ZMinghuiZ/Alex-to-the-Rescue/README.md

# Alex-to-the-Rescue
A tele-operated search and rescue robot using Raspberry Pi, Arduino UNO, Robot Operating System (ROS), color detector and LiDAR. Able to identify obstacles and navigate in unknown environment and generate 2D layout with LiDAR.
