ZMinghuiZ/Alex-to-the-Rescue/tls-alex-client.cpp

// Routines to create a TLS client
#include "make_tls_client.h"

// Network packet types
#include "netconstants.h"

// Packet types, error codes, etc.
#include "constants.h"

#include <conio.h>

// Tells us that the network is running.
static volatile int networkActive=0;

void handleError(const char *buffer)
{
	switch(buffer[1])
	{
		case RESP_OK:
			printf("Command / Status OK\n");
			break;

		case RESP_BAD_PACKET:
			printf("BAD MAGIC NUMBER FROM ARDUINO\n");
			break;

		case RESP_BAD_CHECKSUM:
			printf("BAD CHECKSUM FROM ARDUINO\n");
			break;

		case RESP_BAD_COMMAND:
			printf("PI SENT BAD COMMAND TO ARDUINO\n");
			break;

		case RESP_BAD_RESPONSE:
			printf("PI GOT BAD RESPONSE FROM ARDUINO\n");
			break;

		default:
			printf("PI IS CONFUSED!\n");
	}
}

void handleStatus(const char *buffer)
{
	int32_t data[16];
	memcpy(data, &buffer[1], sizeof(data));

	printf("\n ------- ALEX STATUS REPORT ------- \n\n");
//	printf("Left Forward Ticks:\t\t%d\n", data[0]);
//	printf("Right Forward Ticks:\t\t%d\n", data[1]);
//	printf("Left Reverse Ticks:\t\t%d\n", data[2]);
//	printf("Right Reverse Ticks:\t\t%d\n", data[3]);
//	printf("Left Forward Ticks Turns:\t%d\n", data[4]);
//	printf("Right Forward Ticks Turns:\t%d\n", data[5]);
//	printf("Left Reverse Ticks Turns:\t%d\n", data[6]);
//	printf("Right Reverse Ticks Turns:\t%d\n", data[7]);
//	printf("Forward Distance:\t\t%d\n", data[8]);
//	printf("Reverse Distance:\t\t%d\n", data[9]);

    // display colour according to threshold set in Arduino's code
	if (data[10] == 0)
    {
        printf("Colour: RED\n");
    }
    else if (data[10] == 1)
    {
        printf("Colour: GREEN\n");
    }
    else
    {
        printf("NOT VICTIM\n");
    }

    // display RGB values, in case colour scanning is not accurate so we can determine manually
    printf("RGB: %d - %d - %d\n", data[12], data[14], data[13]);

    printf("gap:\t\t%d\n", data[11]);
	printf("\n---------------------------------------\n\n");
}

void handleMessage(const char *buffer)
{
	printf("MESSAGE FROM ALEX: %s\n", &buffer[1]);
}

void handleCommand(const char *buffer)
{
	// We don't do anything because we issue commands
	// but we don't get them. Put this here
	// for future expansion
}

void handleNetwork(const char *buffer, int len)
{
	// The first byte is the packet type
	int type = buffer[0];

	switch(type)
	{
		case NET_ERROR_PACKET:
		handleError(buffer);
		break;

		case NET_STATUS_PACKET:
		handleStatus(buffer);
		break;

		case NET_MESSAGE_PACKET:
		handleMessage(buffer);
		break;

		case NET_COMMAND_PACKET:
		handleCommand(buffer);
		break;
	}
}

void sendData(void *conn, const char *buffer, int len)
{
	int c;
	printf("\nSENDING %d BYTES DATA\n\n", len);
	if(networkActive)
	{
		/* TODO: Insert SSL write here to write buffer to network */
        c = sslWrite(conn, buffer, len);
		/* END TODO */

		networkActive = (c > 0);
	}
}

void *readerThread(void *conn)
{
	char buffer[128];
	int len;

	while(networkActive)
	{
		/* TODO: Insert SSL read here into buffer */
        len = sslRead(conn, buffer, sizeof(buffer));

        printf("Read %d bytes from server.\n", len);
		/* END TODO */

		networkActive = (len > 0);

		if(networkActive)
			handleNetwork(buffer, len);
	}

	printf("Exiting network listener thread\n");

    /* TODO: Stop the client loop and call EXIT_THREAD */
    stopClient();
    EXIT_THREAD(conn);
    /* END TODO */
}

void flushInput()
{
	char c;

	while((c = getchar()) != '\n' && c != EOF);
}

void getParams(int32_t *params)
{
	printf("Enter distance/angle in cm/degrees (e.g. 50) and power in %% (e.g. 75) separated by space.\n");
	printf("E.g. 50 75 means go at 50 cm at 75%% power for forward/backward, or 50 degrees left or right turn at 75%%  power\n");
	scanf("%d %d", &params[0], &params[1]);
	flushInput();
}

void *writerThread(void *conn)
{
	int quit=0;

	while(!quit)
	{
		char ch;
		printf("Command (p=arrow key control)\n");
		printf("Command (f=forward, b=reverse, l=turn left, r=turn right, s=stop, c=clear stats, g=get stats q=exit)\n");
		scanf("%c", &ch);

		// Purge extraneous characters from input stream
		flushInput();

		char buffer[10];
		int32_t params[2];
		int keypress;

		buffer[0] = NET_COMMAND_PACKET;
		switch(ch)
		{
			case 'f':
			case 'F':
			case 'b':
			case 'B':
			case 'l':
			case 'L':
			case 'r':
			case 'R':
						getParams(params);
						buffer[1] = ch;
						memcpy(&buffer[2], params, sizeof(params));
						sendData(conn, buffer, sizeof(buffer));
						break;
			case 's':
			case 'S':
			case 'c':
			case 'C':
			case 'g':
			case 'G':
					params[0]=0;
					params[1]=0;
					memcpy(&buffer[2], params, sizeof(params));
					buffer[1] = ch;
					sendData(conn, buffer, sizeof(buffer));
					break;
			case 'q':
			case 'Q':
				quit=1;
				break;

            // UI for keyboard controls
            // continuously reads for keypress, then sends pre-determined params
            case 'p':
                printf("WASDzx movement, r/u=f/b hump, t/y=big L/R, g=status, h=stop, q=quit\n");
                keypress = 1;
                while (keypress) {
                    if (kbhit()){
                        switch(getchar()){

                        // WASD movement
                        case 119:     // w - forwards
                            printf("Moving forwards\n");
                            params[0]=3;
                            params[1]=60;
                            buffer[1] = 'b';
                            memcpy(&buffer[2], params, sizeof(params));
                            sendData(conn, buffer, sizeof(buffer));
                            break;
                        case 115:     // s - backwards
                            printf("Moving backwards\n");
                            params[0]=3;
                            params[1]=60;
                            buffer[1] = 'f';
                            memcpy(&buffer[2], params, sizeof(params));
                            sendData(conn, buffer, sizeof(buffer));
                            break;
                        case 97:     // a - left
                            printf("Turning left\n");
                            params[0]=1;
                            params[1]=60;
                            buffer[1] = 'l';
                            memcpy(&buffer[2], params, sizeof(params));
                            sendData(conn, buffer, sizeof(buffer));
                            break;
                        case 100:    // d - right
                            printf("Turning right\n");
                            params[0]=1;
                            params[1]=60;
                            buffer[1] = 'r';
                            memcpy(&buffer[2], params, sizeof(params));
                            sendData(conn, buffer, sizeof(buffer));
                            break;

                        // forward hump - r
                        case 114:
                            printf("Forward hump\n");
                            params[0]=25;
                            params[1]=83;
                            buffer[1] = 'b';
                            memcpy(&buffer[2], params, sizeof(params));
                            sendData(conn, buffer, sizeof(buffer));
                            break;

                        // forward more - z
                        case 122:
                            printf("Moving forwards more\n");
                            params[0]=20;
                            params[1]=60;
                            buffer[1] = 'b';
                            memcpy(&buffer[2], params, sizeof(params));
                            sendData(conn, buffer, sizeof(buffer));
                            break;

                        // backward more - x
                        case 120:
                            printf("Moving backwards more\n");
                            params[0]=15;
                            params[1]=60;
                            buffer[1] = 'f';
                            memcpy(&buffer[2], params, sizeof(params));
                            sendData(conn, buffer, sizeof(buffer));
                            break;

                        // big turn left - t
                        case 116:
                            printf("Big turn left\n");
                            params[0]=7;
                            params[1]=60;
                            buffer[1] = 'l';
                            memcpy(&buffer[2], params, sizeof(params));
                            sendData(conn, buffer, sizeof(buffer));
                            break;

                        // big turn right - y
                        case 121:
                            printf("Big turn right\n");
                            params[0]=4;
                            params[1]=60;
                            buffer[1] = 'r';
                            memcpy(&buffer[2], params, sizeof(params));
                            sendData(conn, buffer, sizeof(buffer));
                            break;

                        // backward hump - u
                        case 117:
                            printf("Backward hump+\n");
                            params[0]=25;
                            params[1]=83;
                            buffer[1] = 'f';
                            memcpy(&buffer[2], params, sizeof(params));
                            sendData(conn, buffer, sizeof(buffer));
                            break;

                        // get status - g
                        case 103:
                            printf("Retrieving status for COLOUR:\n");
                            params[0]=0;
                            params[1]=0;
                            buffer[1] = 'g';
                            memcpy(&buffer[2], params, sizeof(params));
                            sendData(conn, buffer, sizeof(buffer));
                            break;

                        // stop - h
                        case 104:
                            printf("Stopping\n");
                            params[0]=0;
                            params[1]=0;
                            buffer[1] = 's';
                            memcpy(&buffer[2], params, sizeof(params));
                            sendData(conn, buffer, sizeof(buffer));
                            break;

                        // quit - q
                        case 113:
                            printf("Exiting\n");
                            keypress = 0;
                            break;

                        // wrong key info
                        default:
                            printf("Wrong key!\n");
                            printf("WASD movement, e/r=forward+, t/y=big L/R, u=wheelie fix, g=status, h=stop, q=quit\n");
                            break;
                        }
                    }
                }
				break;

			default:
				printf("BAD COMMAND\n");
		}
	}

	printf("Exiting keyboard thread\n");

    /* TODO: Stop the client loop and call EXIT_THREAD */
    stopClient();
    EXIT_THREAD(conn);
    /* END TODO */
}

/* TODO: #define filenames for the client private key, certificatea,
   CA filename, etc. that you need to create a client */
#define CLIENT_KEY_FNAME "laptop.key"
#define CLIENT_CERT_FNAME "laptop.crt"
#define CA_CERT_FNAME "signing.pem"
#define PORT_NUM 5000
#define SERVER_NAME "172.20.10.2"
#define SERVER_NAME_ON_CERT "CEGGRP2"
/* END TODO */

void connectToServer(const char *serverName, int portNum)
{
    /* TODO: Create a new client */
    createClient(SERVER_NAME, PORT_NUM, 1, CA_CERT_FNAME, SERVER_NAME_ON_CERT, 1, CLIENT_CERT_FNAME, CLIENT_KEY_FNAME, readerThread, writerThread);
    /* END TODO */
}

int main(int ac, char **av)
{
	if(ac != 3)
	{
		fprintf(stderr, "\n\n%s <IP address> <Port Number>\n\n", av[0]);
		exit(-1);
	}

    networkActive = 1;
    connectToServer(av[1], atoi(av[2]));

    /* TODO: Add in while loop to prevent main from exiting while the
    client loop is running */
    while(client_is_running());
    /* END TODO */

	printf("\nMAIN exiting\n\n");
}
